RetroSwim/PicoX68Key/kicad/PicoX68Key.kicad_pcb

## KiCad design kicad/PicoX68Key.kicad_pcb (2026-01-07)

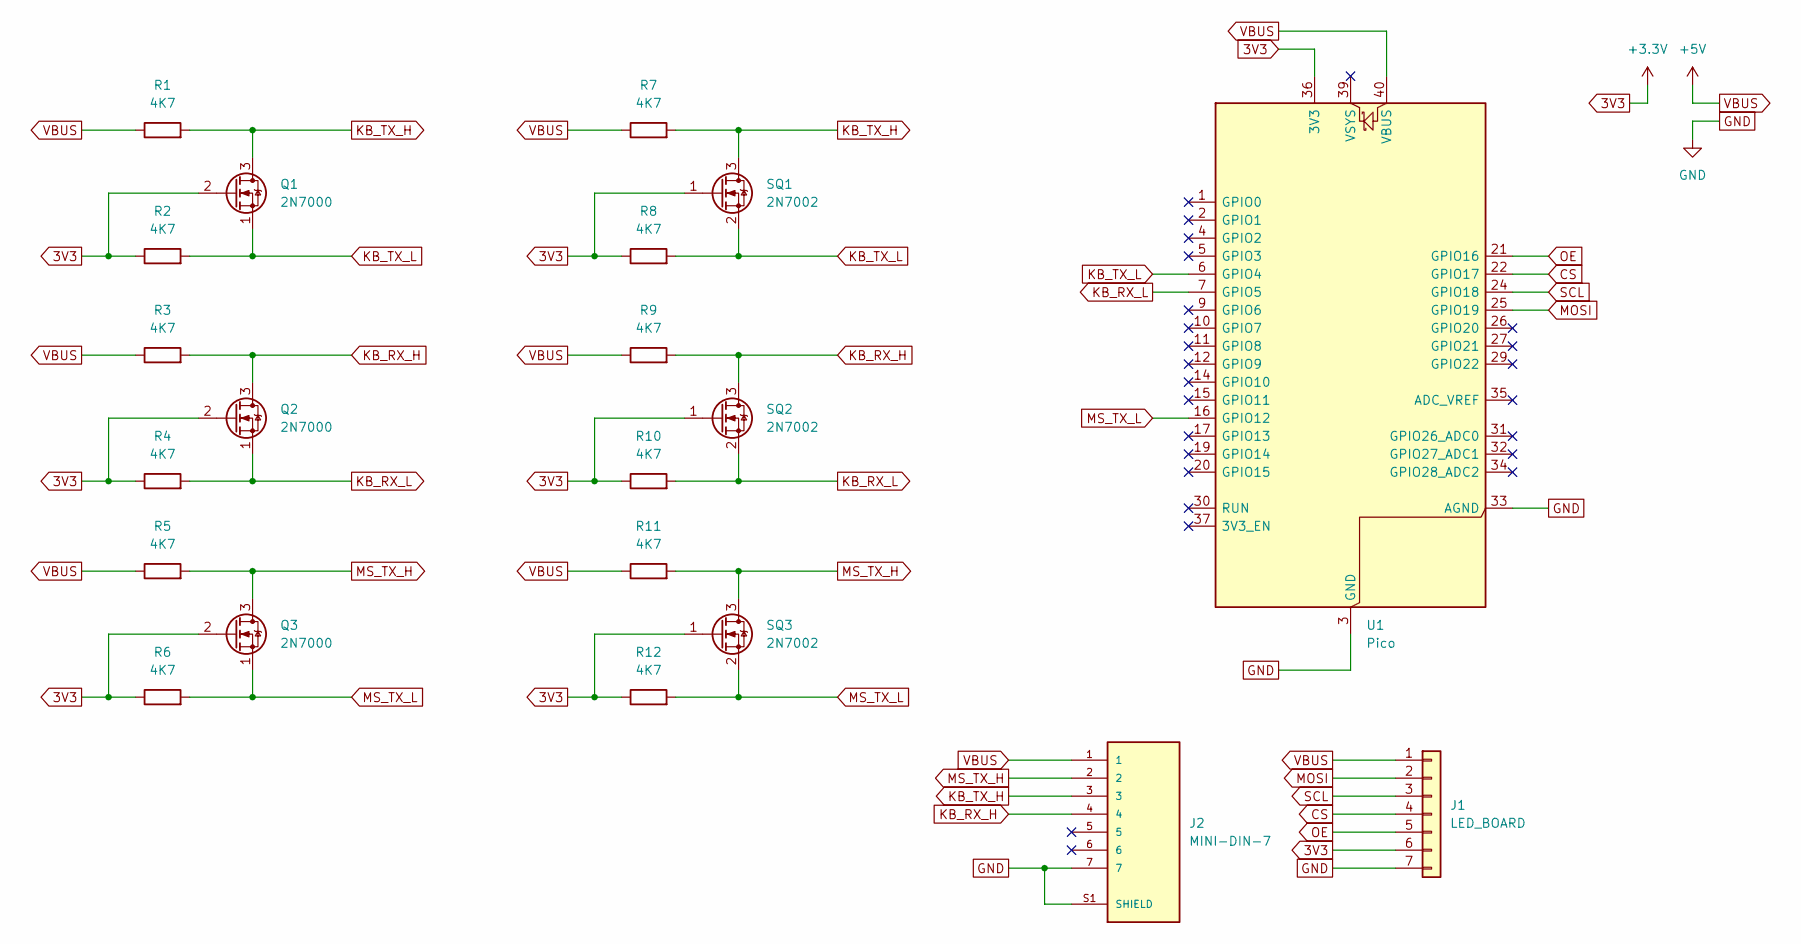
[picture p1: schematic PicoX68Key.kicad_sch]

Parts:
J1: LED_BOARD; PinSocket_1x07_P2.54mm_Vertical
J2: MINI-DIN-7; Mini_DIN_round_7_canned; PARTREV 02/18/2022
Q1, Q2, Q3: 2N7000; TO-92L_Inline_Wide
R1, R2, R3, R4, R5, R6: 4K7; R_Axial_DIN0309_L9.0mm_D3.2mm_P12.70mm_Horizontal
R7, R8, R9, R10, R11, R12: 4K7; R_1206_3216Metric_Pad1.30x1.75mm_HandSolder
SQ1, SQ2, SQ3: 2N7002; SOT-23
U1: Pico; RaspberryPi_Pico_Common

Connections:
3V3: J1.6, Q1.2 (G), Q2.2 (G), Q3.2 (G), R2.1, R4.1, R6.1, R8.1, R10.1, R12.1, SQ1.1 (G), SQ2.1 (G), SQ3.1 (G), U1.36 (3V3)
CS: J1.4, U1.22 (GPIO17)
GND: J1.7, J2.7, J2.S1 (SHIELD), U1.3 (GND), U1.8 (GND), U1.13 (GND), U1.18 (GND), U1.23 (GND), U1.28 (GND), U1.33 (AGND), U1.38 (GND)
KB_RX_H: J2.4, Q2.3 (D), R3.2, R9.2, SQ2.3 (D)
KB_RX_L: Q2.1 (S), R4.2, R10.2, SQ2.2 (S), U1.7 (GPIO5)
KB_TX_H: J2.3, Q1.3 (D), R1.2, R7.2, SQ1.3 (D)
KB_TX_L: Q1.1 (S), R2.2, R8.2, SQ1.2 (S), U1.6 (GPIO4)
MOSI: J1.2, U1.25 (GPIO19)
MS_TX_H: J2.2, Q3.3 (D), R5.2, R11.2, SQ3.3 (D)
MS_TX_L: Q3.1 (S), R6.2, R12.2, SQ3.2 (S), U1.16 (GPIO12)
OE: J1.5, U1.21 (GPIO16)
SCL: J1.3, U1.24 (GPIO18)
VBUS: J1.1, J2.1, R1.1, R3.1, R5.1, R7.1, R9.1, R11.1, U1.40 (VBUS)

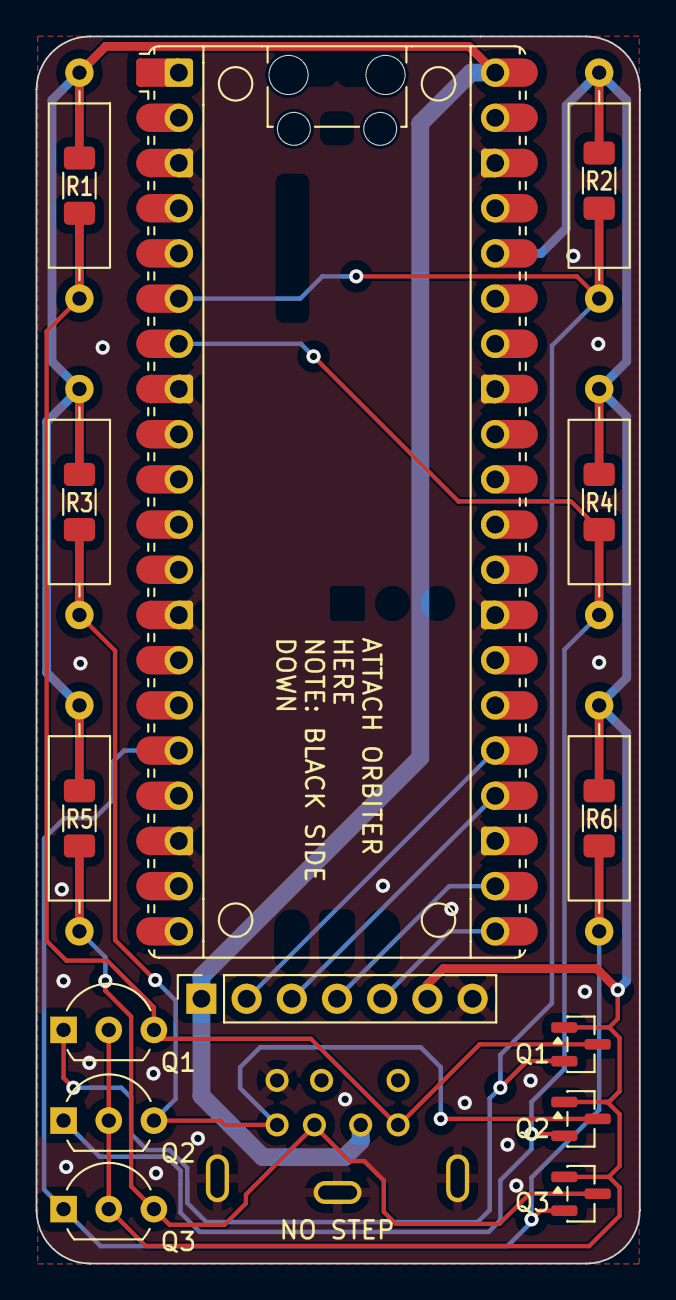
[picture p2: board PicoX68Key.kicad_pcb from above]

Board: 2 copper layers, 33.9 x 69.0 mm, 21 parts (0 on the bottom side), 13 nets.
