RetroSwim/PicoX68Key/kicad/PicoX68Key.LED.kicad_pcb

## KiCad design kicad/PicoX68Key.LED.kicad_pcb (2026-01-07)

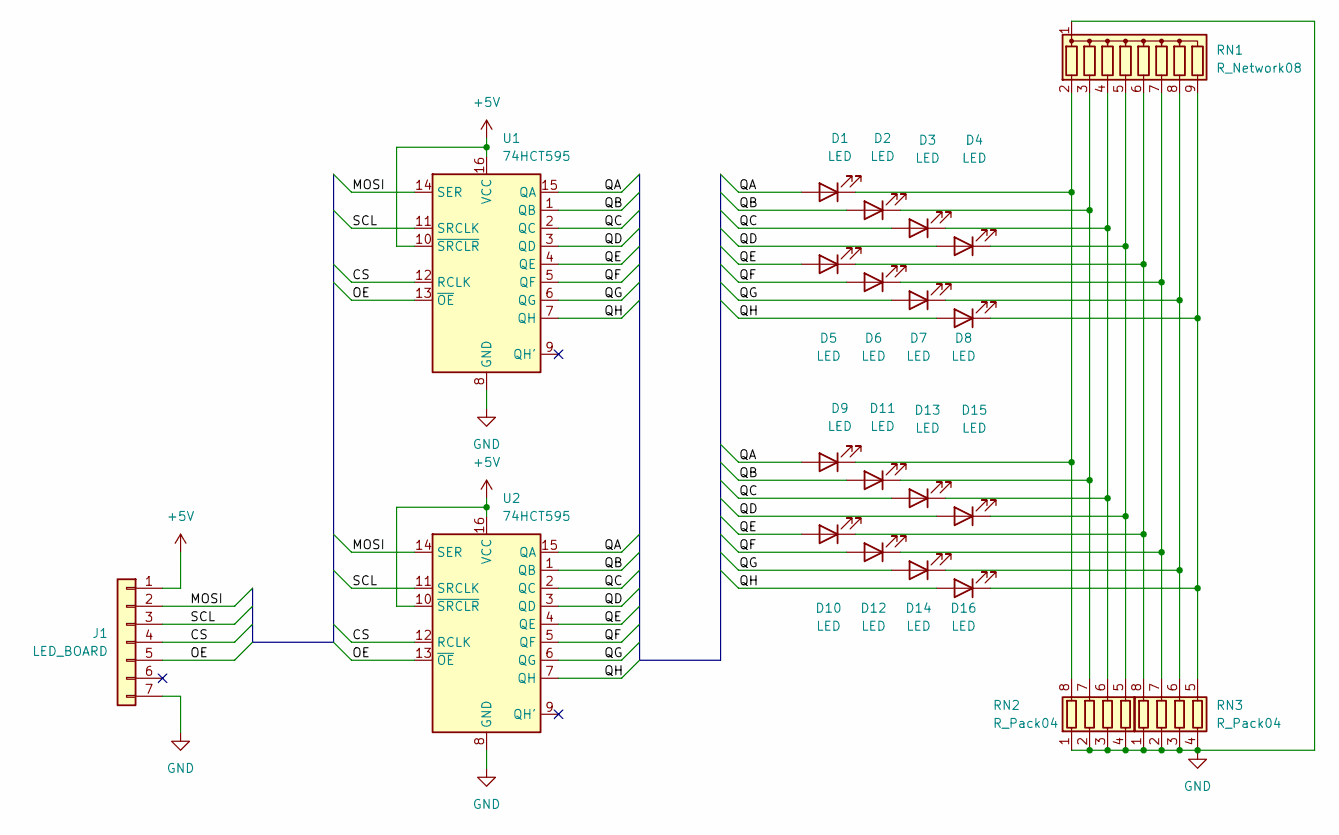
[picture p3: schematic PicoX68Key.LED.kicad_sch]

Parts:
D1, D2, D3, D4, D5, D6, D7, D8: LED; LED_D5.0mm
D9, D10, D11, D12, D13, D14, D15, D16: LED; LED_1206_3216Metric
J1: LED_BOARD; PinSocket_1x07_P2.54mm_Vertical
RN1: R_Network08; R_Array_SIP9
RN2, RN3: R_Pack04
U1: 74HCT595; DIP-16_W7.62mm
U2: 74HCT595; SO-16_3.9x9.9mm_P1.27mm

Connections:
+5V: J1.1, U1.10 (~SRCLR), U1.16 (VCC), U2.10 (~SRCLR), U2.16 (VCC)
/CS: J1.4, U1.12 (RCLK), U2.12 (RCLK)
/MOSI: J1.2, U1.14 (SER), U2.14 (SER)
/OE: J1.5, U1.13 (~OE), U2.13 (~OE)
/QA: D1.2 (A), D9.2 (A), U1.15 (QA), U2.15 (QA)
/QB: D2.2 (A), D11.2 (A), U1.1 (QB), U2.1 (QB)
/QC: D3.2 (A), D13.2 (A), U1.2 (QC), U2.2 (QC)
/QD: D4.2 (A), D15.2 (A), U1.3 (QD), U2.3 (QD)
/QE: D5.2 (A), D10.2 (A), U1.4 (QE), U2.4 (QE)
/QF: D6.2 (A), D12.2 (A), U1.5 (QF), U2.5 (QF)
/QG: D7.2 (A), D14.2 (A), U1.6 (QG), U2.6 (QG)
/QH: D8.2 (A), D16.2 (A), U1.7 (QH), U2.7 (QH)
/SCL: J1.3, U1.11 (SRCLK), U2.11 (SRCLK)
GND: J1.7, RN1.1 (common), RN2.1 (R1.1), RN2.2 (R2.1), RN2.3 (R3.1), RN2.4 (R4.1), RN3.1 (R1.1), RN3.2 (R2.1), RN3.3 (R3.1), RN3.4 (R4.1), U1.8 (GND), U2.8 (GND)
unnamed: D1.1 (K), D9.1 (K), RN1.2 (R1), RN2.8 (R1.2)
unnamed: D5.1 (K), D10.1 (K), RN1.6 (R5), RN3.8 (R1.2)
unnamed: D2.1 (K), D11.1 (K), RN1.3 (R2), RN2.7 (R2.2)
unnamed: D6.1 (K), D12.1 (K), RN1.7 (R6), RN3.7 (R2.2)
unnamed: D3.1 (K), D13.1 (K), RN1.4 (R3), RN2.6 (R3.2)
unnamed: D7.1 (K), D14.1 (K), RN1.8 (R7), RN3.6 (R3.2)
unnamed: D4.1 (K), D15.1 (K), RN1.5 (R4), RN2.5 (R4.2)
unnamed: D8.1 (K), D16.1 (K), RN1.9 (R8), RN3.5 (R4.2)

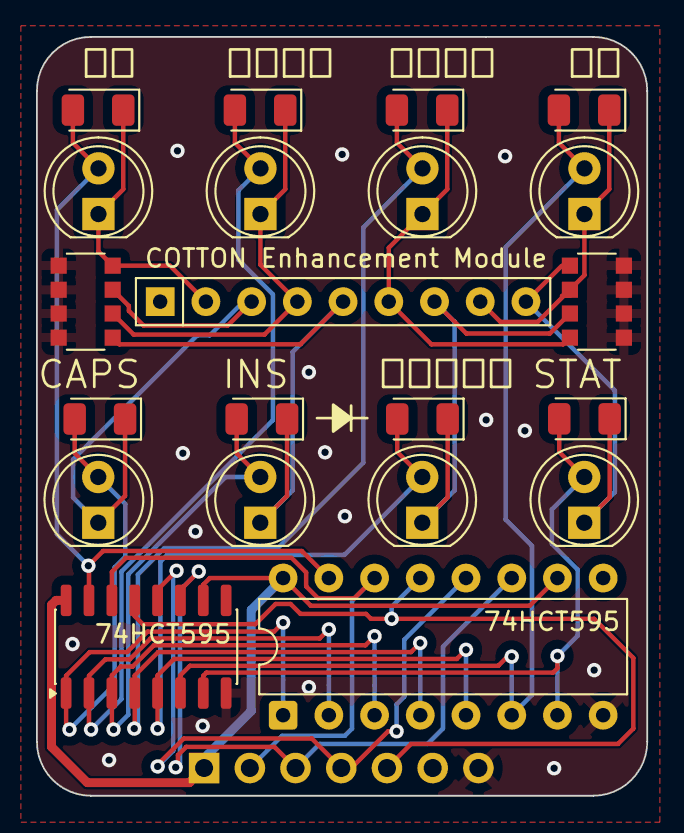
[picture p4: board PicoX68Key.LED.kicad_pcb from above]

Board: 2 copper layers, 33.9 x 42.2 mm, 22 parts (1 on the bottom side), 22 nets.
