RetroSwim/PicoX68Key/PicoX68Key.c

// A better X68000 keyboard adaptor for 2025
// by RetroSwim.

// Credits:
// TinyUSB HID Host implementation example
// https://github.com/raspberrypi/pico-examples/tree/master/usb/host/host_cdc_msc_hid
//
// x68key by Zuofo and Guddler
// https://github.com/Guddler/x68Key
//
// X68000 keyboard protocol information from tmk_keyboard by tmk
// https://github.com/tmk/tmk_keyboard/wiki/Sharp-Keyboard
//
// SharpKey Technical Reference by Philip Smart
// https://eaw.app/sharpkey-technicalguide/
//
// Requirements:
// - Raspberry Pi Pico
// - Level shifter (only really necessary for the input, the X68K keyboard port receives 3v3 just fine)
// - USB OTG adaptor
// - VS Code with Raspberry Pi Pico extension
//
// Wiring:
// - UART0 TXD (pin 16, GP12) - Pin 2 (Mouse Data)
// - UART1 TXD (pin 6, GP4)   - Pin 3 (Keyboard Interface RX)
// - UART1 RXD (pin 7, GP5)   - Level Shifter - Pin 4 (Keyboard Interface TX)
// - VBUS (pin 40)            - Pin 1 (+5VDC)
// - GND (pin 3,8,13,18,etc)  - Pin 7 (GND)
//
// Optional:
// - SPI0 on pins MOSI@GP19 SCK@GP18 CS@GP17 for a shift register (e.g. 74HCT595) to show all
//   the X68000 keyboard LEDs.
// - PWM on pin GP16 to control the brightness of the LEDs (e.g. via ~OE on 74HCT595)

#include <stdio.h>
#include "pico/stdlib.h"
#include "hardware/uart.h"
#include "hardware/spi.h"
#include "hardware/gpio.h"
#include "hardware/pwm.h"
#include "tusb.h"
#include "PicoX68Key.h"
#include "bsp/board_api.h"

#include "include/layout_us.h"

#define KB_UART_ID uart1
#define KB_BAUD_RATE 2400

#define KB_UART_TX_PIN 4
#define KB_UART_RX_PIN 5

#define MOUSE_UART_ID uart0
#define MOUSE_BAUD_RATE 4800

#define MOUSE_UART_TX_PIN 12
#define MOUSE_UART_RX_PIN 13

#define MOUSE_DIVIDER 0x03

#define LED_BOARD_SPI_MOSI 19
#define LED_BOARD_SPI_CLK 18
#define LED_BOARD_SPI_CS 17
#define LED_BOARD_PWM_PIN 16

#define DEFAULT_KEY_REPEAT_DELAY 500 //ms
#define DEFAULT_KEY_REPEAT_RATE 110  //ms

void press(uint8_t c);
void keyDown(uint8_t c);
void keyUp(uint8_t c);
void doRepeat();
void stopRepeat();
bool timerCallback(struct repeating_timer *t);

// void typeCodeForDebug(uint8_t c);
// void testMessage()

extern void hid_app_task(void);

uint8_t newKeyCode = 0;
uint8_t downKeyCode = 0;
uint32_t keyDownTime = 0;
uint16_t repeatDelay = DEFAULT_KEY_REPEAT_DELAY;   // ms before first repeat
struct repeating_timer repeatTimer;

void littleBlink() {
    gpio_put(PICO_DEFAULT_LED_PIN, 1);
    sleep_ms(10);
    gpio_put(PICO_DEFAULT_LED_PIN, 0);
}

// Key repeat timer code
bool timerCallback(struct repeating_timer *t) {
    doRepeat();
    return true;
}

// Press a key
void press(uint8_t c) {
    keyDown(c);
    sleep_ms(10);
    keyUp(c);
    sleep_ms(10);
}

// Send the bytes to the X68000's keyboard interface
void keyDown(uint8_t c) {
    uart_putc(KB_UART_ID, c);
}

void keyUp(uint8_t c) {
    uart_putc(KB_UART_ID, c | 0x80);
}

static uint pwmSliceNumber = 0;
static uint pwmChannel = 0;

static uint8_t lastBrightness = 0;

void setBrightness(uint8_t level) {
    // ~OE is active low. 0% duty cycle = full brightness.
    uint16_t dutyCycle = 0;
    switch(level) {
        case 0: dutyCycle = 0;    break;  // 100% brightness
        case 1: dutyCycle = 6000;  break; // ~75% brightness
        case 2: dutyCycle = 8000;  break; // ~50% brightness
        case 3: dutyCycle = 9500;  break; // ~25% brightness
        default: dutyCycle = 0;    break;  // otherwise on
    }
    pwm_set_chan_level(pwmSliceNumber, pwmChannel, dutyCycle);
    lastBrightness = level;
}

void cycleBrightness() {
    if(lastBrightness == 3){
        setBrightness(0);
    }else{
        setBrightness(lastBrightness + 1);
    }
}

// True while Left GUI (Windows) key is being held. Unlocks additional keys.
bool isSpecial = false;

void setSpecial(bool enabled) {
    isSpecial = enabled;
}

// Translate keystrokes from USB Boot Protocol "Usages" to X68000 scan codes

bool keyIsDown = false;

void handleKey(uint8_t keycode, uint8_t state) {
    
    newKeyCode = keymapping[keycode];

    if(isSpecial) {
        // Brightness key
        if(newKeyCode == 0x2e && state == USBKEY_PRESSED){
            cycleBrightness();
            return;
        }

        // Other GUI key combos
        for(uint8_t i = 0; i < sizeof(altKeysUSB); i++) {
            if(altKeysUSB[i] == keycode) {
                newKeyCode = altKeyCodes[i];
            }
        }
    }

    if(newKeyCode == 0) return;
    
    if(state == USBKEY_PRESSED) {
        keyDown(newKeyCode);
        downKeyCode = newKeyCode;
        keyDownTime = to_ms_since_boot(get_absolute_time());
        keyIsDown = true;
    }else if(state == USBKEY_RELEASED) {
        keyUp(newKeyCode);
        if(newKeyCode == downKeyCode) keyIsDown = false;
    }
}

// Accumulate deltas from USB HID Mouse reports.
uint8_t mouseButtons = 0;
int16_t mouseDx = 0, mouseDy = 0;

void handleMouse(uint8_t buttons, int8_t x, int8_t y) {
    mouseDx += x / MOUSE_DIVIDER;
    mouseDy += y / MOUSE_DIVIDER;
    mouseButtons = buttons;
}

void doRepeat() {
    const uint32_t now = to_ms_since_boot(get_absolute_time());
    if(keyIsDown && (now - keyDownTime) >= repeatDelay) {
        keyDown(downKeyCode);
    }
}

uint8_t sharpToSubBoard(uint8_t led_mask) {
    uint8_t subBoardLeds = 0;
    
    if(led_mask & SHARP_LED_KANA)      subBoardLeds |= SUBBOARD_LED_KANA;
    if(led_mask & SHARP_LED_CAPS)      subBoardLeds |= SUBBOARD_LED_CAPS;
    if(led_mask & SHARP_LED_ROMAN)     subBoardLeds |= SUBBOARD_LED_ROMAN;
    if(led_mask & SHARP_LED_CHORD)     subBoardLeds |= SUBBOARD_LED_CHORD;
    if(led_mask & SHARP_LED_INS)       subBoardLeds |= SUBBOARD_LED_INS;
    if(led_mask & SHARP_LED_HIRAGANA)  subBoardLeds |= SUBBOARD_LED_HIRAGANA;
    if(led_mask & SHARP_LED_WIDE)      subBoardLeds |= SUBBOARD_LED_WIDE;
    if(led_mask & SHARP_LED_STATUS)    subBoardLeds |= SUBBOARD_LED_STATUS;

    return subBoardLeds;
}

static uint8_t lastSubBoardLeds = 0;

void setSubBoardLeds(uint8_t led_mask) {
    gpio_put(LED_BOARD_SPI_CS, 0);
    spi_write_blocking(spi0, (void *)&led_mask, 1);
    gpio_put(LED_BOARD_SPI_CS, 1);
}

void setSubBoardStatusLed(bool isOn) {
    uint8_t newSubBoardLedBits = lastSubBoardLeds;
    if(isOn) {
        newSubBoardLedBits = (lastSubBoardLeds & 0x7f) | 0x80;
    }else{
        newSubBoardLedBits = (lastSubBoardLeds & 0x7f);
    }
    setSubBoardLeds(newSubBoardLedBits);
    lastSubBoardLeds = newSubBoardLedBits;
}


void ledOn(bool isOn) {
    gpio_put(PICO_DEFAULT_LED_PIN, isOn);
    setSubBoardStatusLed(isOn);
}


int main()
{
    uint8_t lastByte = 0;
    
    tuh_hid_set_default_protocol(HID_PROTOCOL_BOOT);
    tuh_init(BOARD_TUH_RHPORT);
    board_init_after_tusb();

    uart_init(KB_UART_ID, KB_BAUD_RATE);
    uart_init(MOUSE_UART_ID, MOUSE_BAUD_RATE);
    uart_set_format(MOUSE_UART_ID, 8, 2, UART_PARITY_NONE);
    
    gpio_set_function(KB_UART_TX_PIN, GPIO_FUNC_UART);
    gpio_set_function(KB_UART_RX_PIN, GPIO_FUNC_UART);

    gpio_set_function(MOUSE_UART_TX_PIN, GPIO_FUNC_UART);
    gpio_set_function(MOUSE_UART_RX_PIN, GPIO_FUNC_UART);

    spi_init(spi0, 1000000);
    gpio_set_function(LED_BOARD_SPI_CLK, GPIO_FUNC_SPI);
    gpio_set_function(LED_BOARD_SPI_MOSI, GPIO_FUNC_SPI);
    
    gpio_init(LED_BOARD_SPI_CS);
    gpio_set_dir(LED_BOARD_SPI_CS, GPIO_OUT);
    gpio_put(LED_BOARD_SPI_CS, 1);
    lastSubBoardLeds = 0;
    setSubBoardLeds(0);

    gpio_init(PICO_DEFAULT_LED_PIN);
    gpio_set_dir(PICO_DEFAULT_LED_PIN, GPIO_OUT);

    gpio_set_function(LED_BOARD_PWM_PIN, GPIO_FUNC_PWM);
    pwmSliceNumber = pwm_gpio_to_slice_num(LED_BOARD_PWM_PIN);
    pwmChannel = pwm_gpio_to_channel(LED_BOARD_PWM_PIN);
    pwm_set_wrap(pwmSliceNumber, 10000);
    pwm_set_chan_level(pwmSliceNumber, pwmChannel, 9500); // Low brightness initially
    pwm_set_enabled(pwmSliceNumber, true);
    
    add_repeating_timer_ms(DEFAULT_KEY_REPEAT_RATE, timerCallback, NULL, &repeatTimer);
    
    while (true) {
        tuh_task();
        hid_app_task();

        while(uart_is_readable(KB_UART_ID)){

            const uint8_t thisByte = uart_getc(KB_UART_ID);

            // 0x4x replicates the MSCTRL pin on the mouse port. Bit 0 falling means poll now.
            // 0b01000001 then 0b01000000 = poll
            if(thisByte == 0x40 && lastByte == 0x41){
                uint8_t mousePacket[3];
                uint8_t xOvp = 0, xOvn = 0, yOvp = 0, yOvn = 0;

                // Mouse deltas have 10 bits of precision, packed awkwardly into 3 bytes.
                if (mouseDx > 127)  xOvp = 1;
                if (mouseDx < -128) xOvn = 1;
                if (mouseDy > 127)	yOvp = 1;
                if (mouseDy < -128) yOvn = 1;

                mousePacket[0] = (yOvn << 7) | (yOvp << 6) | (xOvn << 5) | (xOvp << 4) | mouseButtons;
                mousePacket[1] = mouseDx;
                mousePacket[2] = mouseDy;
                mouseDx = 0;
                mouseDy = 0;
                for (int i = 0; i < 3; i++) uart_putc(MOUSE_UART_ID, mousePacket[i]);

            }

            // 0x5x sets LED brightness
            if((thisByte & 0xfc) == 0x5c)
            {
                // last 2 bits
                // 00 full brightness
                // 01 75%
                // 10 50%
                // 11 25%

                const uint8_t brightnessByte = thisByte & 0x03;

                setBrightness(brightnessByte);

            }

            // 0x6x sets keyboard repeat rate
            if((thisByte & 0xf0) == 0x60)
            {
                // low nibble	time ms
                // 0	        30
                // 1	        35
                // 2	        50
                // 3	        75
                // 4	        110 <-- default
                // 5	        155
                // 6	        210
                // 7	        275
                // 8	        350
                // 9	        435
                // a	        530
                // b	        635
                // c	        750
                // d	        875
                // e	        1010
                // f	        1155

                const uint16_t rateByte = thisByte & 0x0f; 
                const uint16_t rateMs = 30 + ((rateByte ^ 2) * 5);
                repeatTimer.delay_us = (uint64_t)rateMs * 1000;
            }

            // 0x7x sets keyboard repeat delay
            if((thisByte & 0xf0) == 0x70)
            {
                // low nibble	time ms
                // 0	        200
                // 1	        300
                // 2	        400
                // 3	        500 <-- default
                // 4	        600
                // 5	        700
                // 6	        800
                // 7	        900
                // 8	        1000
                // 9	        1100
                // a	        1200
                // b	        1300
                // c	        1400
                // d	        1500
                // e	        1600
                // f	        1700

                const uint16_t delayByte = thisByte & 0x0f; 
                const uint16_t delayMs = 200 + (delayByte * 100);
                repeatDelay = delayMs;
            }

            // 0x8x sets the keyboard LEDs.
            // bit 6   全角 (Wide)
            // bit 5   ひらがな (Hiragana)
            // bit 4   INS
            // bit 3   CAPS
            // bit 2   コード入力 (Chord entry)
            // bit 1   ローマ字 (Roman characters)
            // bit 0   かな (Kana)
            if((thisByte & 0x80) == 0x80) {
                const uint8_t notLedBits = ~thisByte;     // 0 = on
                const uint8_t newSubBoardLedBits = (lastSubBoardLeds & 0x80) | sharpToSubBoard(notLedBits); // Preserve status LED bit
                // LEDs on HID keyboard
                set_leds(notLedBits);

                // LEDs on sub-board
                setSubBoardLeds(newSubBoardLedBits);

                lastSubBoardLeds = newSubBoardLedBits;
                
            }

            lastByte = thisByte;
        }
    }

}

// void typeCodeForDebug(uint8_t c) {
//        
//   static const uint8_t hexDigitToKeycodeLut[] = {0x0B, 0x02, 0x03, 0x04, 0x05, 0x06, 0x07, 0x08, 0x09, 0x0A, 0x1E, 0x2E, 0x2C, 0x20, 0x13, 0x21};
//   const uint8_t highNibble = (c & 0xf0) >> 4;
//   const uint8_t lowNibble = c & 0x0f;

//   press(hexDigitToKeycodeLut[highNibble]);
//   press(hexDigitToKeycodeLut[lowNibble]);
    
//   press(0x35);

// }

// void testMessage() {
//
//     //                                    h     e     l     l     o     r     l     d -- うさぎさんこんにちは！
//     static const uint8_t message[] = { 0x23, 0x13, 0x26, 0x26, 0x19, 0x35, 0x26, 0x20 };

//     for(uint8_t i = 0; i < sizeof(message); i++) {
//         press(message[i]);
//     }

//     keyDown(0x70);
//     //       !
//     press(0x02);
//     keyUp(0x70);

// }
