RetroSwim/PicoX68Key/(commit log)

2025-11-25 Cherry-pick code changes from kicad branch
2025-12-02 Add LED sub-board
    [PicoX68Key.LED.kicad_pcb, PicoX68Key.LED.kicad_sch, PicoX68Key.kicad_pcb]
2025-12-24 Create LED board and tweak designs
    [PicoX68Key-B_Cu.gbr, PicoX68Key-B_Mask.gbr, PicoX68Key-B_Silkscreen.gbr, PicoX68Key-Edge_Cuts.gbr, PicoX68Key-F_Cu.gbr, PicoX68Key-F_Mask.gbr, PicoX68Key-F_Paste.gbr, PicoX68Key-F_Silkscreen.gbr]
2025-12-24 Changed some settings to make 3D view look better
    [PicoX68Key.kicad_pcb]
2026-01-03 Fixed LED sub board code
    [PicoX68Key.c]
2026-01-03 Fix some project problems
    [PicoX68Key.c]
2026-01-03 Fix typo in status led control
    [PicoX68Key.c]
2026-01-03 Fixed B2B interconnect clearance
    [PicoX68Key.LED.kicad_pcb, PicoX68Key.kicad_pcb]
2026-01-04 Fix ground plane
    [PicoX68Key.LED.kicad_pcb]
2026-01-04 Add PWM functionality to set LED brightness
    [PicoX68Key.LED.kicad_pcb, PicoX68Key.LED.kicad_sch, PicoX68Key.kicad_pcb, PicoX68Key.kicad_sch]
2026-01-04 Add label for OE/PWM pin on interconnect
    [PicoX68Key.kicad_pcb]
2026-01-04 Updated credits
    [PicoX68Key.kicad_pcb]
2026-01-07 Changes to enable brightness control. Final PCB polish.
    [PicoX68Key.LED.kicad_pcb, PicoX68Key.kicad_pcb]
